thura-robotics/stm32-line_follower/pcb/pcb_render/STM32F4_LineFollower.png

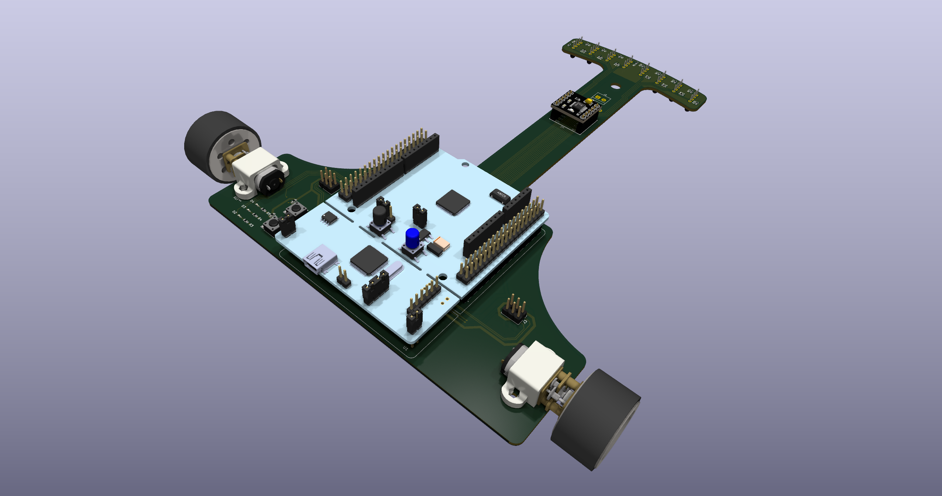
pcb/pcb_render/STM32F4_LineFollower.png
