thura-robotics/stm32-line_follower/mechanical/README.md

# About this directory
Place the PDF schematic output here.
