thura-robotics/stm32-line_follower/pcb/3d_models/Modulo_DRV8833_A.stp

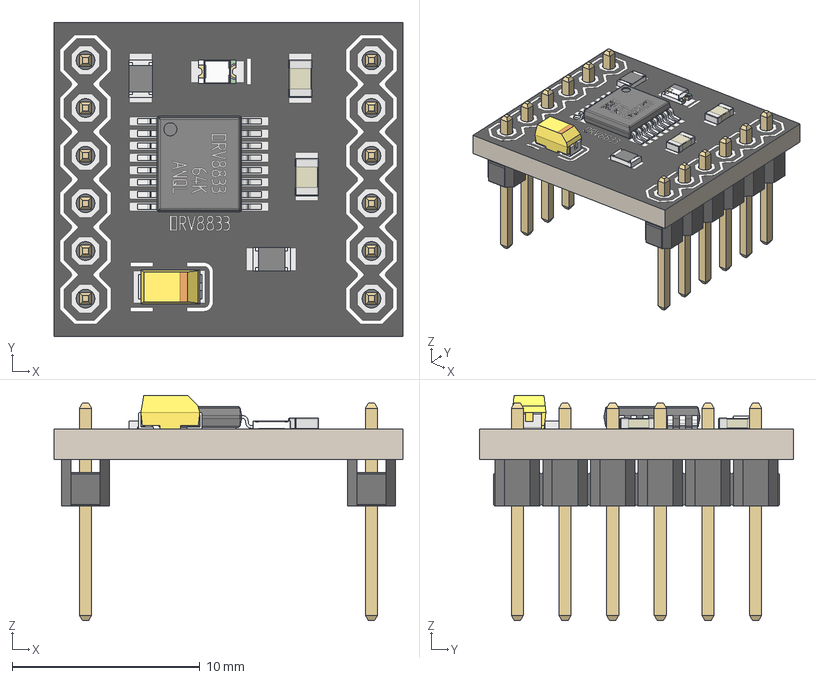
[picture p2: CAD file, 2026-05-17]
pcb/3d_models/Modulo_DRV8833_A.stp
18.6 x 16.8 x 12.0 mm
placa
TSSOP_cuerpo_1.2h
TSSOP_pin_6.6 x 2
PIN_macho_1x6 x 2
T494A
C0805_060 x 2
R0805 x 2
housing
marking x 2
cover
base_2
base
