thura-robotics/stm32-line_follower/pcb/3d_models/6-Pin Header - Female - 2.54mm.step

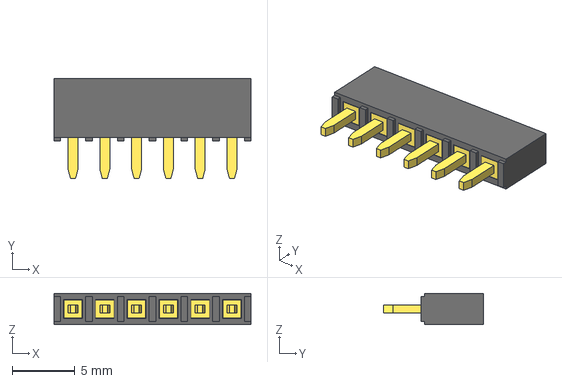
[picture p3: CAD file, 2026-05-17]
pcb/3d_models/6-Pin Header - Female - 2.54mm.step
15.7 x 8.00 x 2.50 mm
