thura-robotics/stm32-line_follower/pcb/3d_models/38-Pin Header - Female - Double - 2.54mm.step

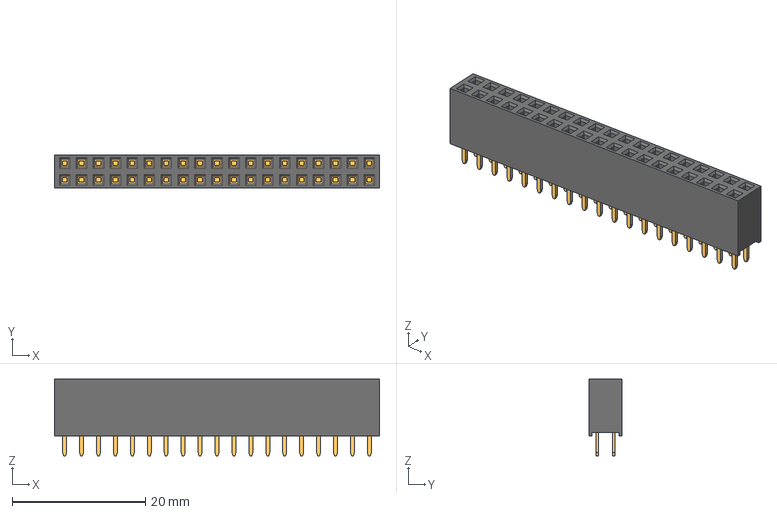
[picture p4: CAD file, 2026-05-17]
pcb/3d_models/38-Pin Header - Female - Double - 2.54mm.step
48.8 x 5.00 x 11.5 mm
