thura-robotics/stm32-line_follower/pcb/schematic_pdf/STM32F4_LineFollower.pdf

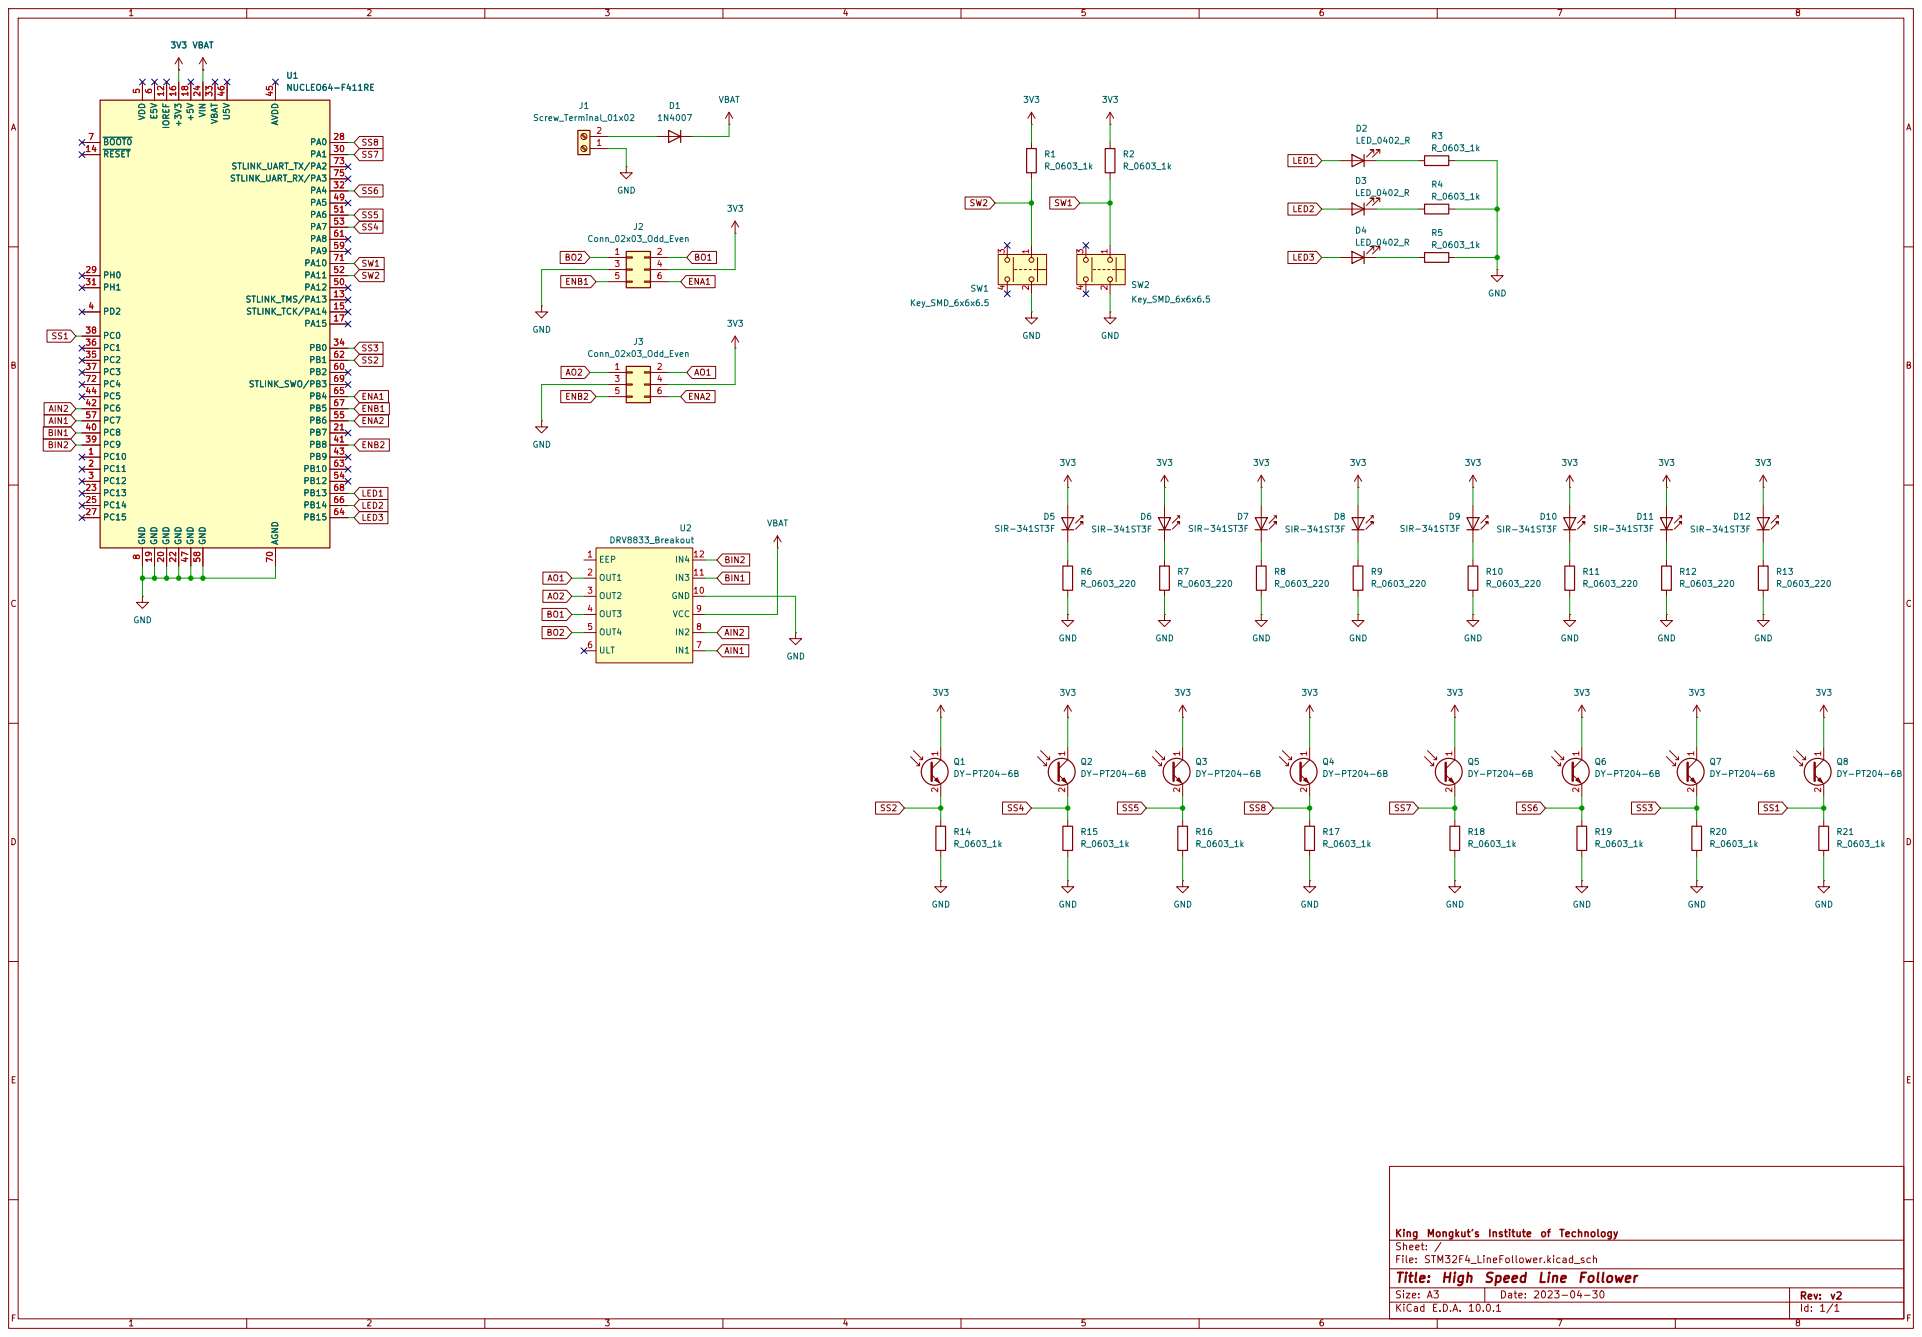
[picture p5: page 1]

King Mongkut's Institute of Technology
Sheet: /
File: STM32F4_LineFollower.kicad_sch
Title: High Speed Line Follower

Size: A3 | Rev: v2 | F Date: 2023-04-30
KiCad E.D.A. 10.0.1 | Id: 1/1
