thura-robotics/stm32-line_follower/pcb/STM32F4_LineFollower.kicad_pcb

## KiCad design pcb/STM32F4_LineFollower.kicad_pcb (2026-05-17)

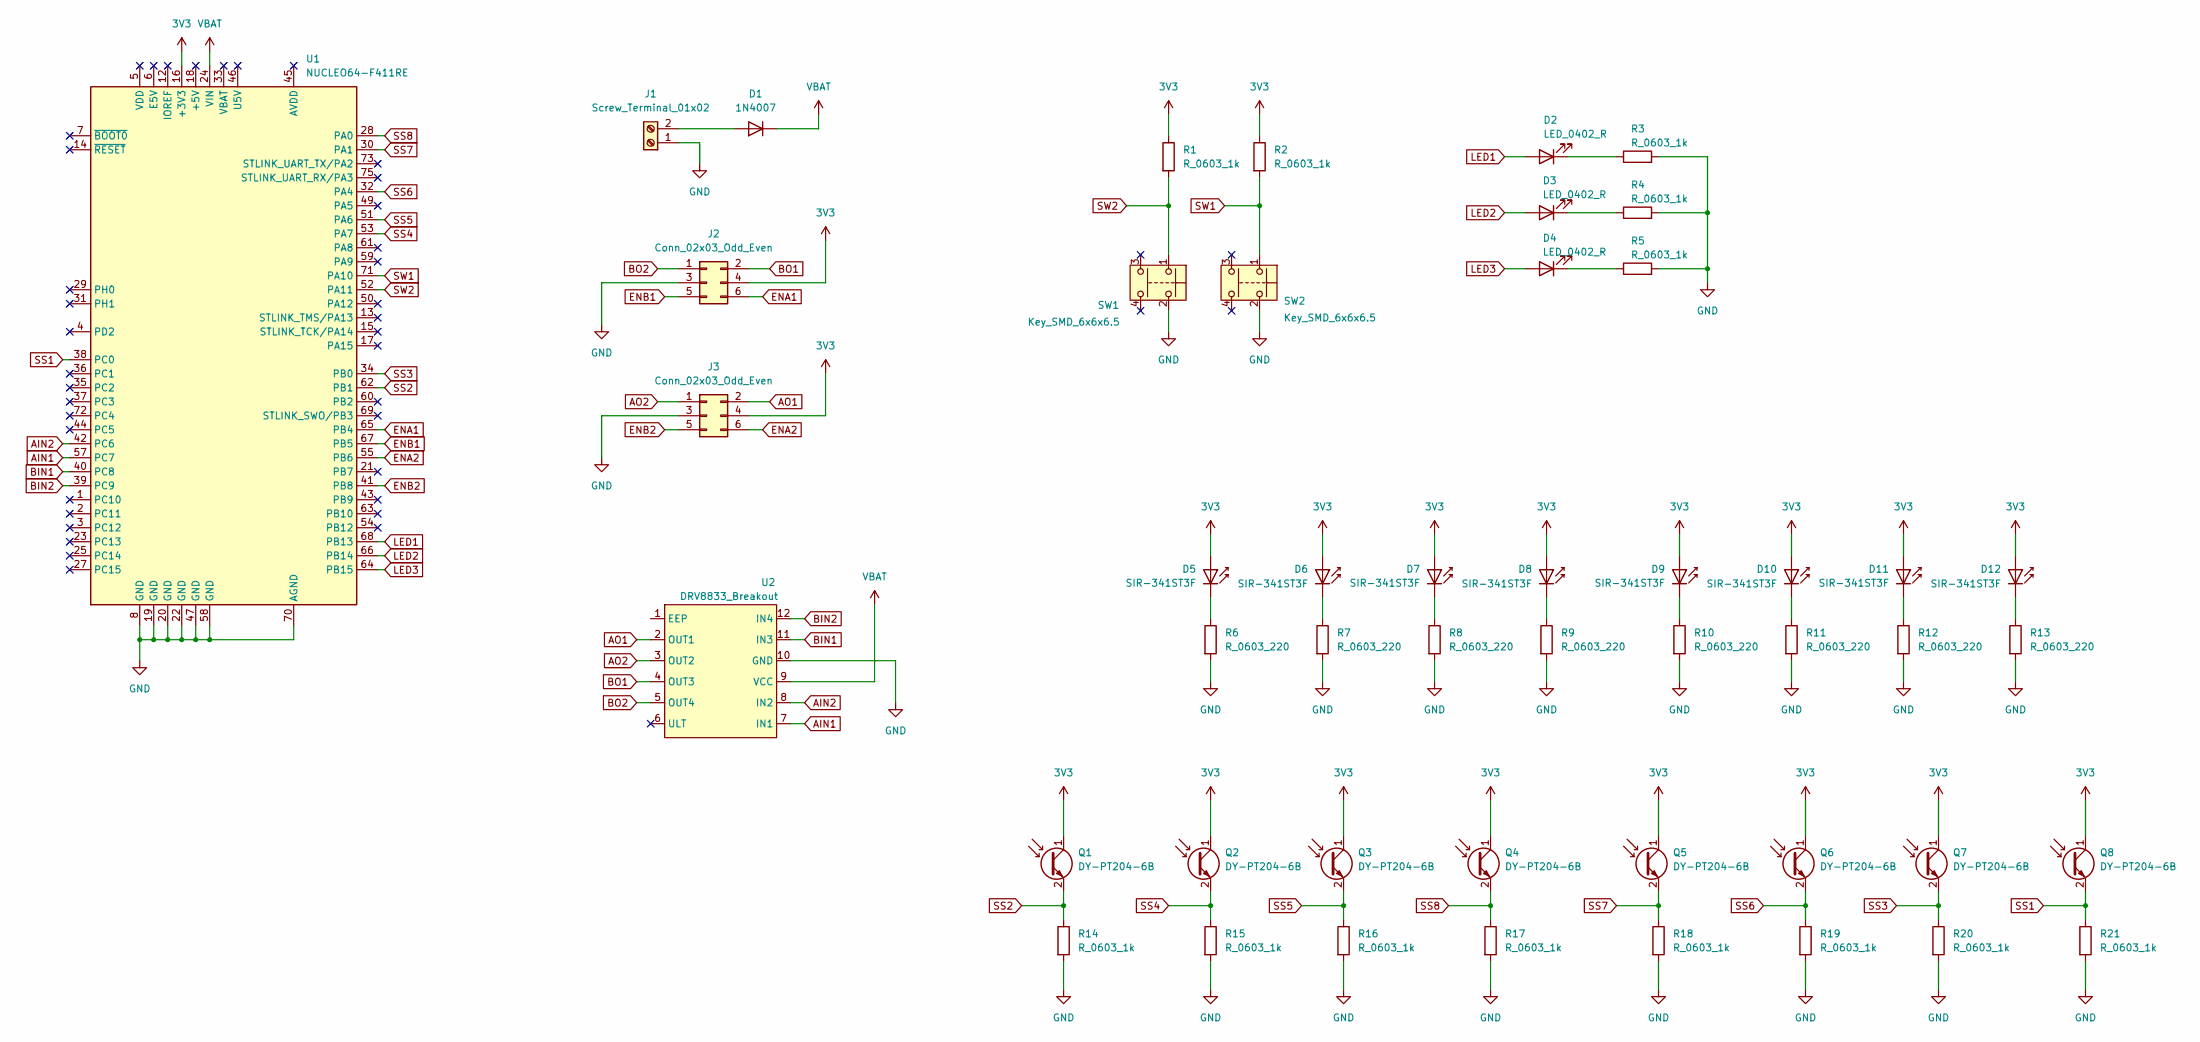
[picture p6: schematic STM32F4_LineFollower.kicad_sch, High Speed Line Follower]

Parts:
D1: 1N4007; D_DO-41_SOD81_P10.16mm_Horizontal
D2, D3, D4: LED_0402_R; LED_0402_1005Metric_Pad0.77x0.64mm_HandSolder
D5, D6, D7, D8, D9, D10, D11, D12: SIR-341ST3F; LED_D3.0mm_Clear
J1: Screw_Terminal_01x02; TerminalBlock_4Ucon_1x02_P3.50mm_Horizontal
J2, J3: Conn_02x03_Odd_Even; PinHeader_2x03_P2.54mm_Vertical
Q1, Q2, Q3, Q4, Q5, Q6, Q7, Q8: DY-PT204-6B; LED_D3.0mm_IRBlack
R1, R2, R3, R4, R5, R14, R15, R16, R17, R18, R19, R20, R21: R_0603_1k; R_0603_1608Metric_Pad0.98x0.95mm_HandSolder
R6, R7, R8, R9, R10, R11, R12, R13: R_0603_220; R_0603_1608Metric_Pad0.98x0.95mm_HandSolder
SW1, SW2: Key_SMD_6x6x6.5; SW_Push_1P1T_NO_E-Switch_TL3301NxxxxxG_v2
U1: NUCLEO64-F411RE; BOARD_NUCLEO-F411RE
U2: DRV8833_Breakout

Connections:
3V3: D5.2 (A), D6.2 (A), D7.2 (A), D8.2 (A), D9.2 (A), D10.2 (A), D11.2 (A), D12.2 (A), J2.4, J3.4, Q1.1 (C), Q2.1 (C), Q3.1 (C), Q4.1 (C), Q5.1 (C), Q6.1 (C), Q7.1 (C), Q8.1 (C), R1.1, R2.1, U1.16 (+3V3)
AIN1: U1.57 (PC7), U2.7 (IN1)
AIN2: U1.42 (PC6), U2.8 (IN2)
AO1: J3.2, U2.2 (OUT1)
AO2: J3.1, U2.3 (OUT2)
BIN1: U1.40 (PC8), U2.11 (IN3)
BIN2: U1.39 (PC9), U2.12 (IN4)
BO1: J2.2, U2.4 (OUT3)
BO2: J2.1, U2.5 (OUT4)
ENA1: J2.6, U1.65 (PB4)
ENA2: J3.6, U1.55 (PB6)
ENB1: J2.5, U1.67 (PB5)
ENB2: J3.5, U1.41 (PB8)
GND: J1.1, J2.3, J3.3, R3.2, R4.2, R5.2, R6.2, R7.2, R8.2, R9.2, R10.2, R11.2, R12.2, R13.2, R14.2, R15.2, R16.2, R17.2, R18.2, R19.2, R20.2, R21.2, SW1.2, SW2.2, U1.8 (GND), U1.19 (GND), U1.20 (GND), U1.22 (GND), U1.47 (GND), U1.58 (GND), U1.70 (AGND), U2.10 (GND)
LED1: D2.2 (A), U1.68 (PB13)
LED2: D3.2 (A), U1.66 (PB14)
LED3: D4.2 (A), U1.64 (PB15)
unnamed: D1.2 (A), J1.2
unnamed: D2.1 (K), R3.1
unnamed: D3.1 (K), R4.1
unnamed: D4.1 (K), R5.1
unnamed: D5.1 (K), R6.1
unnamed: D6.1 (K), R7.1
unnamed: D7.1 (K), R8.1
unnamed: D8.1 (K), R9.1
unnamed: D9.1 (K), R10.1
unnamed: D10.1 (K), R11.1
unnamed: D11.1 (K), R12.1
unnamed: D12.1 (K), R13.1
SS1: Q8.2 (E), R21.1, U1.38 (PC0)
SS2: Q1.2 (E), R14.1, U1.62 (PB1)
SS3: Q7.2 (E), R20.1, U1.34 (PB0)
SS4: Q2.2 (E), R15.1, U1.53 (PA7)
SS5: Q3.2 (E), R16.1, U1.51 (PA6)
SS6: Q6.2 (E), R19.1, U1.32 (PA4)
SS7: Q5.2 (E), R18.1, U1.30 (PA1)
SS8: Q4.2 (E), R17.1, U1.28 (PA0)
SW1: R2.2, SW2.1, U1.71 (PA10)
SW2: R1.2, SW1.1, U1.52 (PA11)
VBAT: D1.1 (K), U1.24 (VIN), U2.9 (VCC)

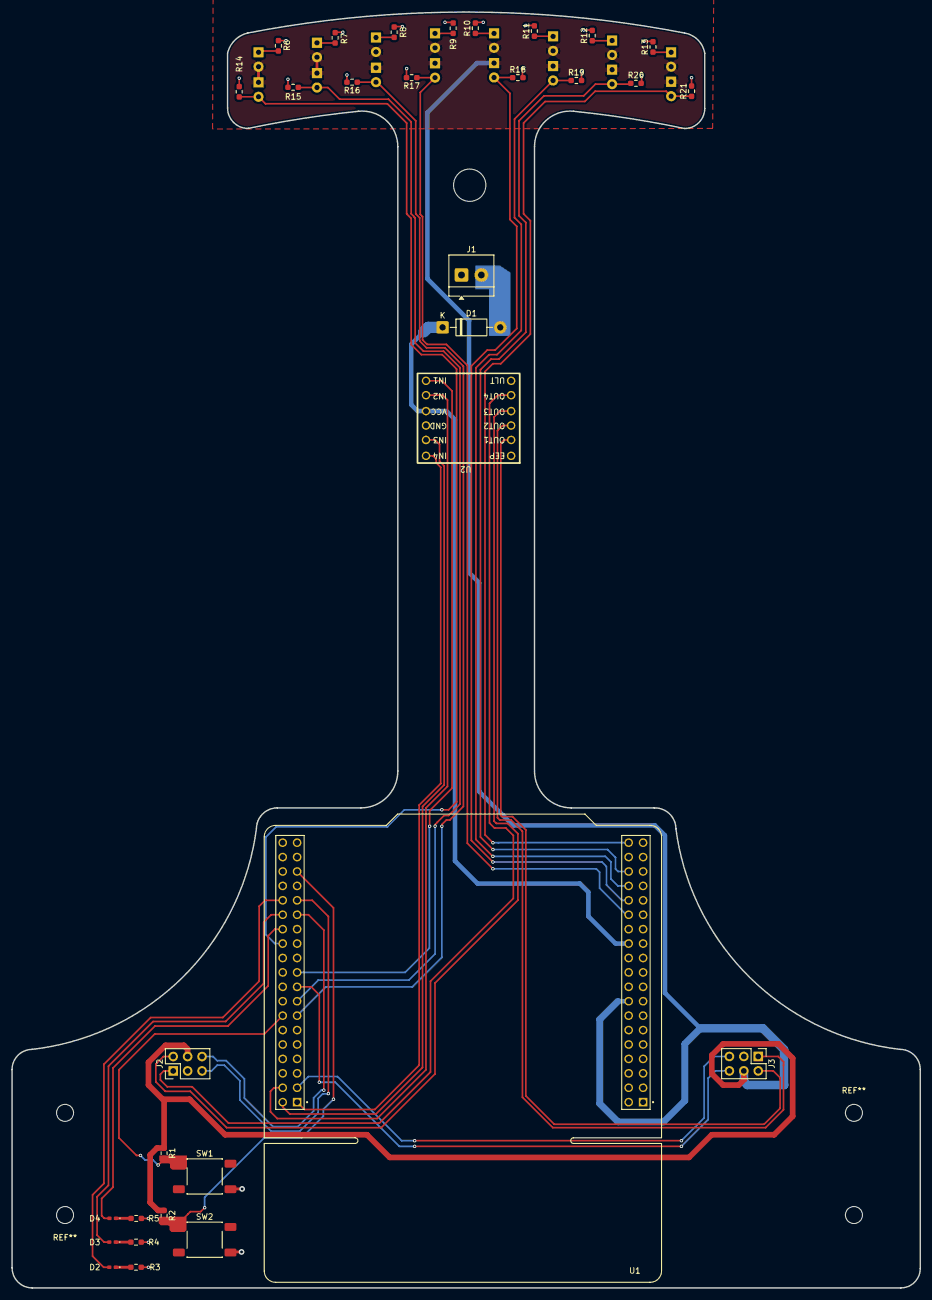
[picture p7: board STM32F4_LineFollower.kicad_pcb from above]

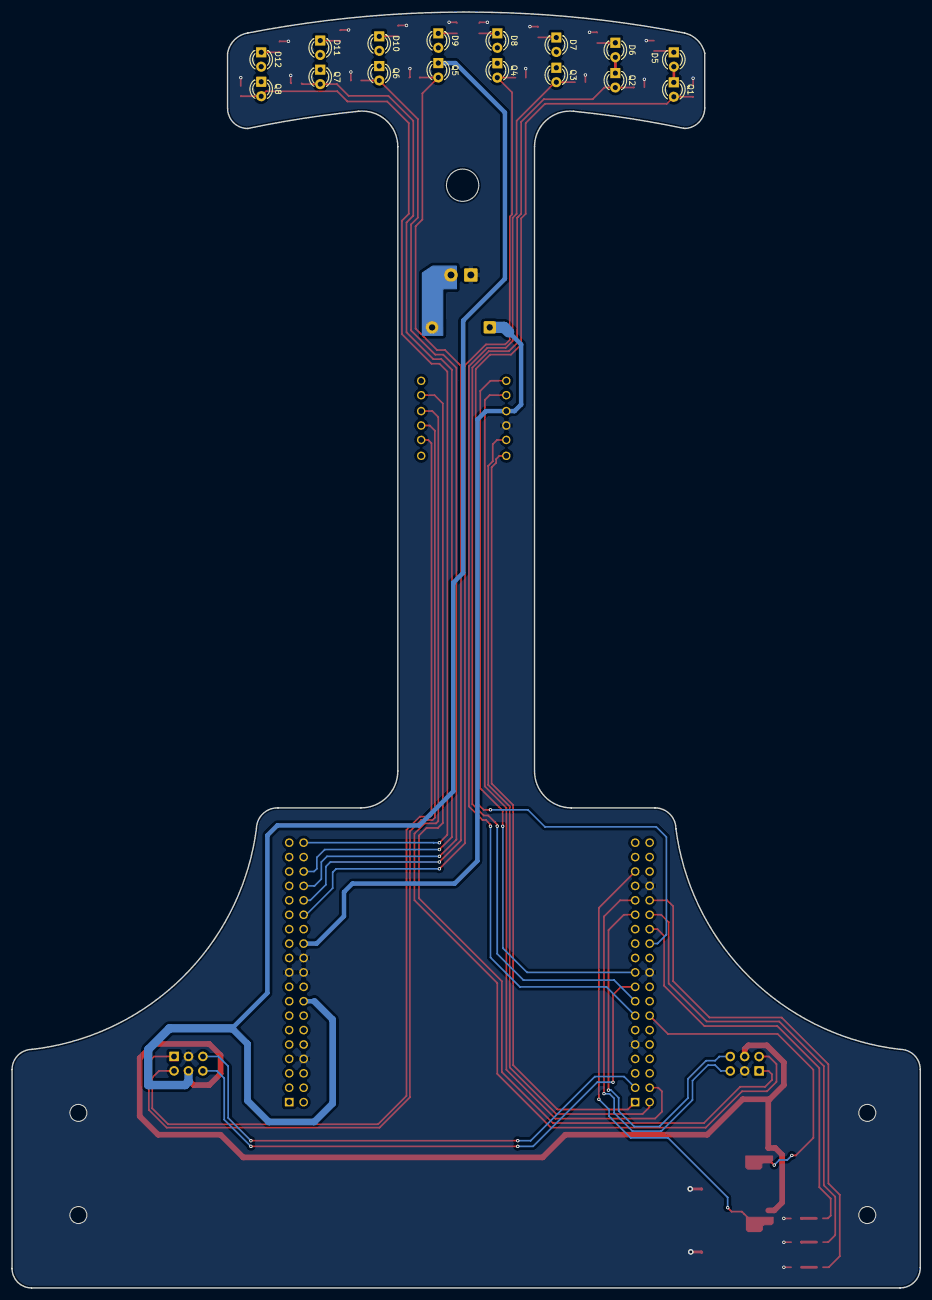
[picture p8: board STM32F4_LineFollower.kicad_pcb from below]

Board: 2 copper layers, 160.0 x 224.8 mm, 48 parts (16 on the bottom side), 40 nets.
