thura-robotics/stm32-line_follower/firmware/Core/Src/main.c

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
/* Includes ------------------------------------------------------------------*/
#include "main.h"

/* USER CODE BEGIN Includes */
#include "stdio.h"
#include "string.h"
/* USER CODE END Includes */

/* USER CODE BEGIN PD */
#define ADC_BUF_LEN 16
/* USER CODE END PD */

ADC_HandleTypeDef hadc1;
DMA_HandleTypeDef hdma_adc1;

TIM_HandleTypeDef htim3;
TIM_HandleTypeDef htim10;

UART_HandleTypeDef huart2;

/* USER CODE BEGIN PV */
uint16_t adc_current[ADC_BUF_LEN];
uint32_t sensors_max[8], sensors_min[8];
float previousLvalue1, previousLvalue2, previousLvalue3 ,previousRvalue1 ,previousRvalue2, previousRvalue3;
float norm_ss[8];
unsigned char text1[100];
unsigned char text2[100];
float sum_norm_ss = 0;
float position = 0;
float error = 0;
float error_previous = 0;
float error_integral = 0;
float error_derivative = 0;
float setpoint = 0;
float rightMotor;
float leftMotor;
float kp = 2;
float ki = 0.01;
float kd = 0.32;
float pidCalculate;
float linear_v = 100;

float dt = 0.05;

/* USER CODE END PV */

void SystemClock_Config(void);
static void MX_GPIO_Init(void);
static void MX_DMA_Init(void);
static void MX_ADC1_Init(void);
static void MX_USART2_UART_Init(void);
static void MX_TIM3_Init(void);
static void MX_TIM10_Init(void);
/**
  * @brief  The application entry point.
  * @retval int
  */
int main(void)
{
  /* MCU Configuration--------------------------------------------------------*/

  /* Reset of all peripherals, Initializes the Flash interface and the Systick. */
  HAL_Init();

  /* Configure the system clock */
  SystemClock_Config();

  /* Initialize all configured peripherals */
  MX_GPIO_Init();
  MX_DMA_Init();
  MX_ADC1_Init();
  MX_USART2_UART_Init();
  MX_TIM3_Init();
  MX_TIM10_Init();
  /* USER CODE BEGIN 2 */
  HAL_ADC_Start_DMA(&hadc1, (uint32_t*)adc_current, ADC_BUF_LEN);
  HAL_TIM_PWM_Start(&htim3 , TIM_CHANNEL_1);
  HAL_TIM_PWM_Start(&htim3 , TIM_CHANNEL_3);
  HAL_TIM_PWM_Start(&htim3 , TIM_CHANNEL_2);
  HAL_TIM_PWM_Start(&htim3 , TIM_CHANNEL_4);

//  HAL_GPIO_WritePin(GPIOC, GPIO_PIN_7, GPIO_PIN_RESET);
//  HAL_GPIO_WritePin(GPIOC, GPIO_PIN_9, GPIO_PIN_RESET);
  for(int i=0; i<8; i++){
  	  sensors_min[i] = 4095;
  	  sensors_max[i]=0;
    }
  HAL_TIM_Base_Start_IT(&htim10);
  /* USER CODE END 2 */

  /* Infinite loop */
  /* USER CODE BEGIN WHILE */
  while (1)
    {
	  if (HAL_GPIO_ReadPin(GPIOA, GPIO_PIN_5) == 0)
	  {
		  pidCalculate = 0;
	  }
	  if (HAL_GPIO_ReadPin(GPIOA, GPIO_PIN_10) == 0){

	  			for(int i=0; i<8; i++){
	  			   sensors_min[i] = 4095;
	  			   sensors_max[i] = 0;
	  			}
	  		 }
	  		 while(HAL_GPIO_ReadPin(GPIOA, GPIO_PIN_11) == 0){
	  		  for (int i=0; i<8; i++){
	  		   if (sensors_max[i]<adc_current[i]){
	  			sensors_max[i]=adc_current[i];
	  			  }
	  		   if (sensors_min[i]>adc_current[i]){
	  			sensors_min[i]=adc_current[i];
	  			  }
	  		  }
	  		 }

    /* USER CODE END WHILE */

    /* USER CODE BEGIN 3 */
    }
  /* USER CODE END 3 */
}

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
/* USER CODE BEGIN 4 */
void HAL_TIM_PeriodElapsedCallback(TIM_HandleTypeDef *htim){
	if(htim == &htim10){
		sum_norm_ss=0;

		for (int i=0;i<8;i++){
		  norm_ss[i]=1-((float)adc_current[i]-(float)sensors_min[i])/ ((float)sensors_max[i]-(float)sensors_min[i]);
		  sum_norm_ss += norm_ss[i];
	  }
		position = ((-50*norm_ss[0])+(-35.72*norm_ss[1])+(-21.44*norm_ss[2])+(-7.16*norm_ss[5])+(7.16*norm_ss[7])+(21.44*norm_ss[3])+(35.72*norm_ss[4])+(50*norm_ss[6]));
//		sprintf(&text1, "%.2f,%.2f,%.2f,%.2f,%.2f,%.2f,%.2f,%.2f\r\n", norm_ss[6],norm_ss[4],norm_ss[3],norm_ss[7],norm_ss[5],norm_ss[2],norm_ss[1],norm_ss[0]);
		sprintf(&text1, "%.2f\r\n", position);
		HAL_UART_Transmit(&huart2, text1, strlen(text1), 1000);
		if(position < -50) position = -50;
		if(position > 50) position = 50;

	error = position - setpoint;
	error_integral += error*dt;
	error_derivative = (error - error_previous)/dt;
	error_previous = error ;
	pidCalculate = kp*error + ki*error_integral + kd*error_derivative;
	rightMotor = linear_v + pidCalculate;
	leftMotor = linear_v - pidCalculate;
	if(rightMotor>100) rightMotor = 100;
	if(rightMotor<0) rightMotor = 0;
	if(leftMotor>100) leftMotor = 100;
	if(leftMotor<0) leftMotor = 0;
	sprintf(&text2, "leftMotor=%.2f rightMotor=%.2f Position=%.2f Error = %.2f pidCalculate = %.2f \r\n",leftMotor, rightMotor, position, error, pidCalculate);
//	HAL_UART_Transmit(&huart2, text2, strlen(text2), 1000);
//
	if(norm_ss[1] >0.4 || norm_ss[2] > 0.4 || norm_ss[3] >0.4 || norm_ss[4] > 0.4 || norm_ss[5] >0.4 || norm_ss [7] >0.4)
	{
		//forward
		TIM3->CCR1 = leftMotor-15; //100*leftMotor/100;
		TIM3->CCR2 = 0;
		TIM3->CCR3 = rightMotor-15; //100*rightMotor/100;
		TIM3->CCR4 = 0;

	}else{
		 if(previousLvalue1 >0.4 || previousLvalue2 >0.4 || previousLvalue3 >0.4){
			 // Reverse left Motor
			 			TIM3->CCR1 = 90; //100*leftMotor/100;
			 			TIM3->CCR2 = 0;
			 		    TIM3->CCR3 = 0; //100*rightMotor/100;
			 			TIM3->CCR4 = 90;

		 }
		 if(previousRvalue1 > 0.4 || previousRvalue2 > 0.4 || previousRvalue3 > 0.4){

			 // Reverse right motor
			 TIM3->CCR1 = 0; //100*leftMotor/100;
			 TIM3->CCR2 = 90;
			 TIM3->CCR3 = 90; //100*rig htMotor/100;
			 TIM3->CCR4 = 0;

		 }
	}


	previousLvalue1 = norm_ss[0];
	previousLvalue2 = norm_ss[1];
	previousLvalue3 = norm_ss[2];
	previousRvalue1 = norm_ss[3];
	previousRvalue2 = norm_ss[4];
	previousRvalue3 = norm_ss[6];



//	TIM3->CCR1 = leftMotor-10; //100*leftMotor/100;
//	TIM3->CCR3 = rightMotor-10; //100*rightMotor/100;
//	TIM3->CCR4 = 0;
//	TIM3->CCR2 = 0;
	}
}
/* USER CODE END 4 */
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
