thura-robotics/stm32-line_follower/firmware/LineFollowerFinalVersion.ioc

Mcu.UserName=STM32F411RETx
PA0-WKUP.Signal=ADCx_IN0
PA1.Signal=ADCx_IN1
PA10.GPIO_Label=Right Switch
PA10.Signal=GPIO_Input
PA11.GPIO_Label=Left Switch
PA11.Signal=GPIO_Input
PA2.Signal=USART2_TX
PA3.Signal=USART2_RX
PA4.Signal=ADCx_IN4
PA5.GPIO_Label=LED ON STM
PA5.Signal=GPIO_Output
PA6.Signal=ADCx_IN6
PA7.Signal=ADCx_IN7
PB0.Signal=ADCx_IN8
PB1.Signal=ADCx_IN9
PB13.Signal=GPIO_Output
PB14.Signal=GPIO_Output
PB15.Signal=GPIO_Output
PB4.GPIO_Label=ENA1
PB4.Signal=GPIO_Input
PB5.GPIO_Label=ENB1
PB5.Signal=GPIO_Input
PB6.GPIO_Label=ENA2
PB6.Signal=GPIO_Input
PB8.GPIO_Label=ENB2
PB8.Signal=GPIO_Input
PC0.Signal=ADCx_IN10
PC1.Signal=ADCx_IN11
PC13-ANTI_TAMP.GPIO_Label=Blue Button
PC13-ANTI_TAMP.Signal=GPIO_Input
PC2.Signal=ADCx_IN12
PC6.GPIO_Label=TIM3_CH1(PC6)_L
PC6.Signal=S_TIM3_CH1
PC7.GPIO_Label=L_TIM3_CH2
PC7.Signal=S_TIM3_CH2
PC8.GPIO_Label=TIM3_CH3(PC8)_R
PC8.Signal=S_TIM3_CH3
PC9.GPIO_Label=R_TIM3_CH4
PC9.Signal=S_TIM3_CH4
