thura-robotics/stm32-line_follower/firmware/Core/Inc/main.h

#define Blue_Button_Pin GPIO_PIN_13
#define Blue_Button_GPIO_Port GPIOC
#define LED_ON_STM_Pin GPIO_PIN_5
#define LED_ON_STM_GPIO_Port GPIOA
#define TIM3_CH1_L_Pin GPIO_PIN_6
#define TIM3_CH1_L_GPIO_Port GPIOC
#define L_TIM3_CH2_Pin GPIO_PIN_7
#define L_TIM3_CH2_GPIO_Port GPIOC
#define TIM3_CH3_R_Pin GPIO_PIN_8
#define TIM3_CH3_R_GPIO_Port GPIOC
#define R_TIM3_CH4_Pin GPIO_PIN_9
#define R_TIM3_CH4_GPIO_Port GPIOC
#define Right_Switch_Pin GPIO_PIN_10
#define Right_Switch_GPIO_Port GPIOA
#define Left_Switch_Pin GPIO_PIN_11
#define Left_Switch_GPIO_Port GPIOA
#define ENA1_Pin GPIO_PIN_4
#define ENA1_GPIO_Port GPIOB
#define ENB1_Pin GPIO_PIN_5
#define ENB1_GPIO_Port GPIOB
#define ENA2_Pin GPIO_PIN_6
#define ENA2_GPIO_Port GPIOB
#define ENB2_Pin GPIO_PIN_8
#define ENB2_GPIO_Port GPIOB
